SuperPixelElectronics/STM32_Navigation_Mapping_Car/外壳/电机固定.STEP

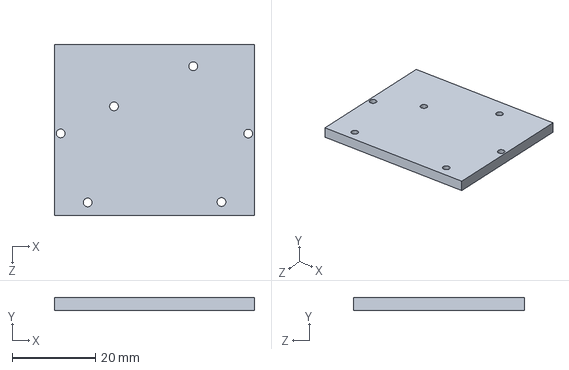
[picture p7: CAD file, 2026-03-30]
外壳/电机固定.STEP
48.0 x 3.00 x 41.0 mm
