SuperPixelElectronics/STM32_Navigation_Mapping_Car/(list of files, cad)

Other CAD files:
外壳/电机固定.SLDPRT
