SuperPixelElectronics/STM32_Navigation_Mapping_Car/其他文档/小车调试笔记.pdf

选型

## 遥控器测试

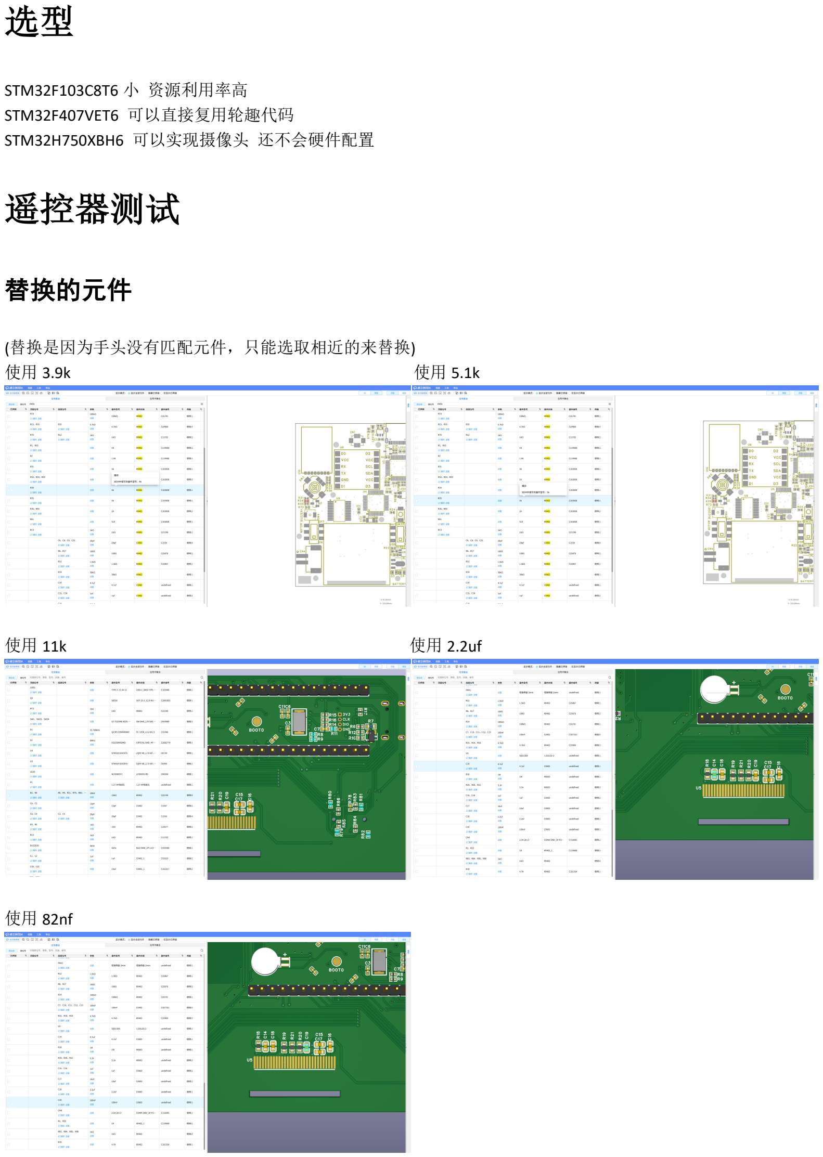
[picture p8: page 1]

STM32F103C8T6 小 资源利用率高
STM32F407VET6 可以直接复用轮趣代码
STM32H750XBH6 可以实现摄像头 还不会硬件配置

替换的元件

(替换是因为手头没有匹配元件，只能选取相近的来替换)
使用 3.9k | 使用 5.1k
使用 11k | 使用 2.2uf

使用 82nf

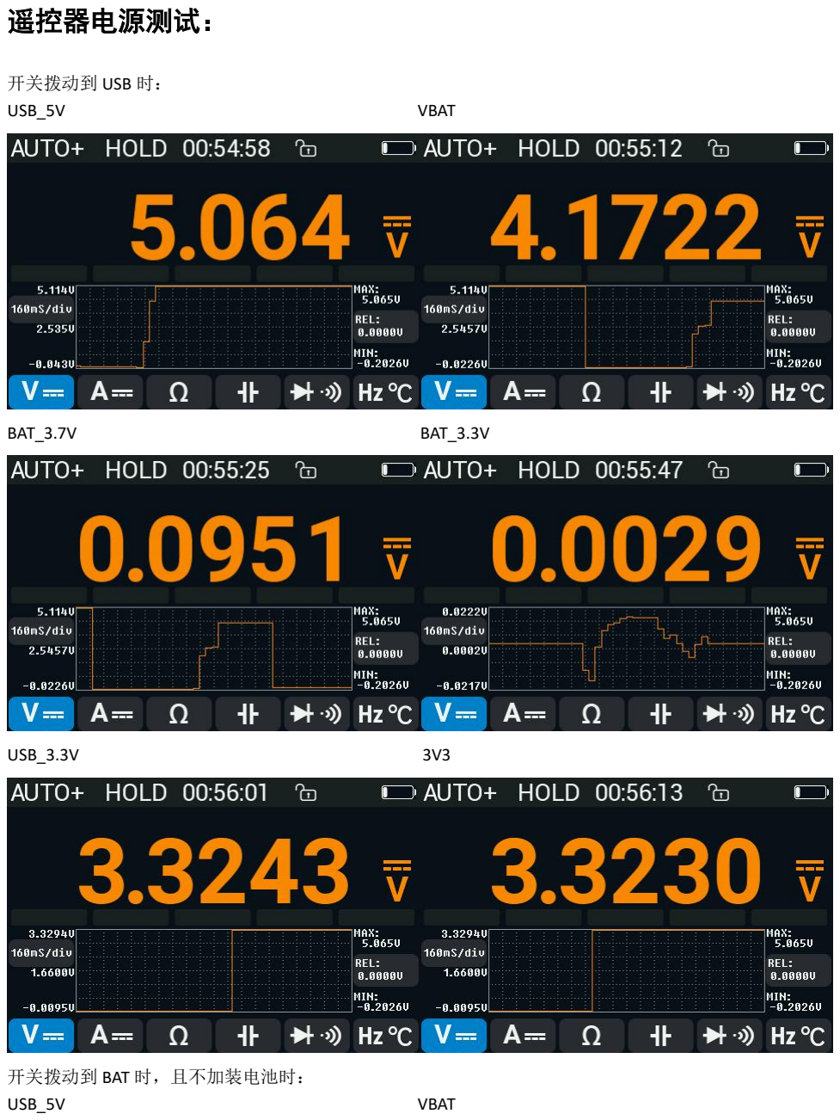
[picture p9: page 2]

遥控器电源测试：

开关拨动到 USB 时：
USB_5V | VBAT
BAT_3.7V | BAT_3.3V
USB_3.3V | 3V3

开关拨动到 BAT 时，且不加装电池时：
USB_5V | VBAT

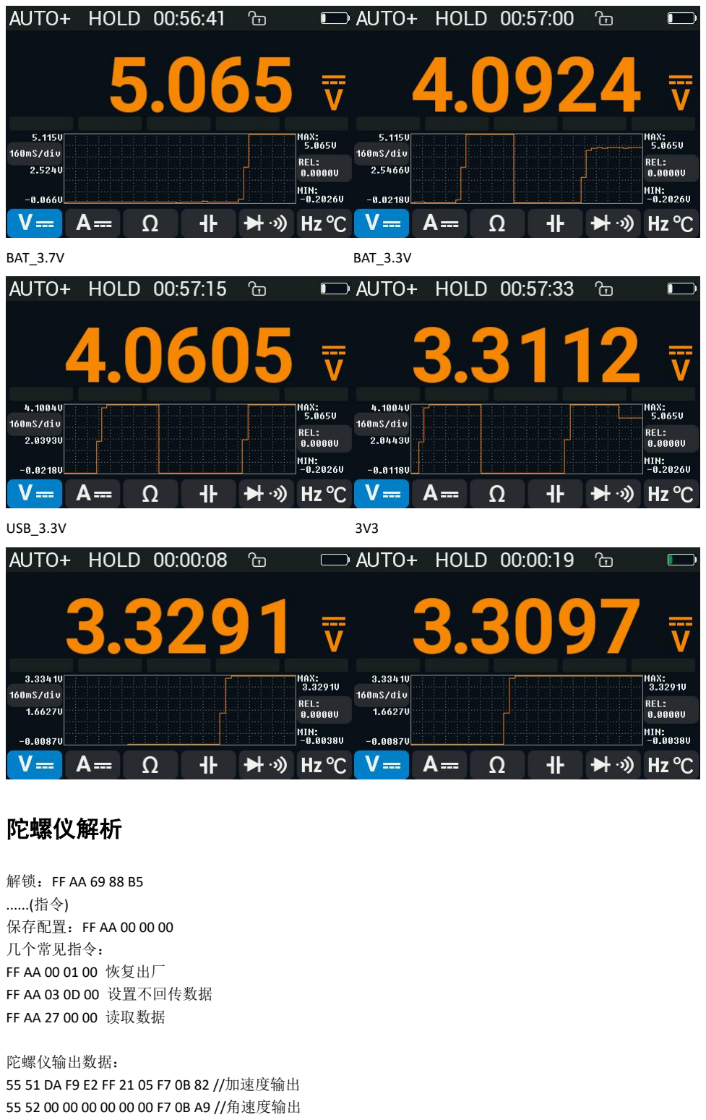
[picture p10: page 3]

BAT_3.7V | BAT_3.3V
USB_3.3V | 3V3

陀螺仪解析

解锁：FF AA 69 88 B5
......(指令)
保存配置：FF AA 00 00 00
几个常见指令：
FF AA 00 01 00 恢复出厂
FF AA 03 0D 00 设置不回传数据
FF AA 27 00 00 读取数据

陀螺仪输出数据：
55 51 DA F9 E2 FF 21 05 F7 0B 82 //加速度输出 55 52 00 00 00 00 00 00 F7 0B A9 //角速度输出

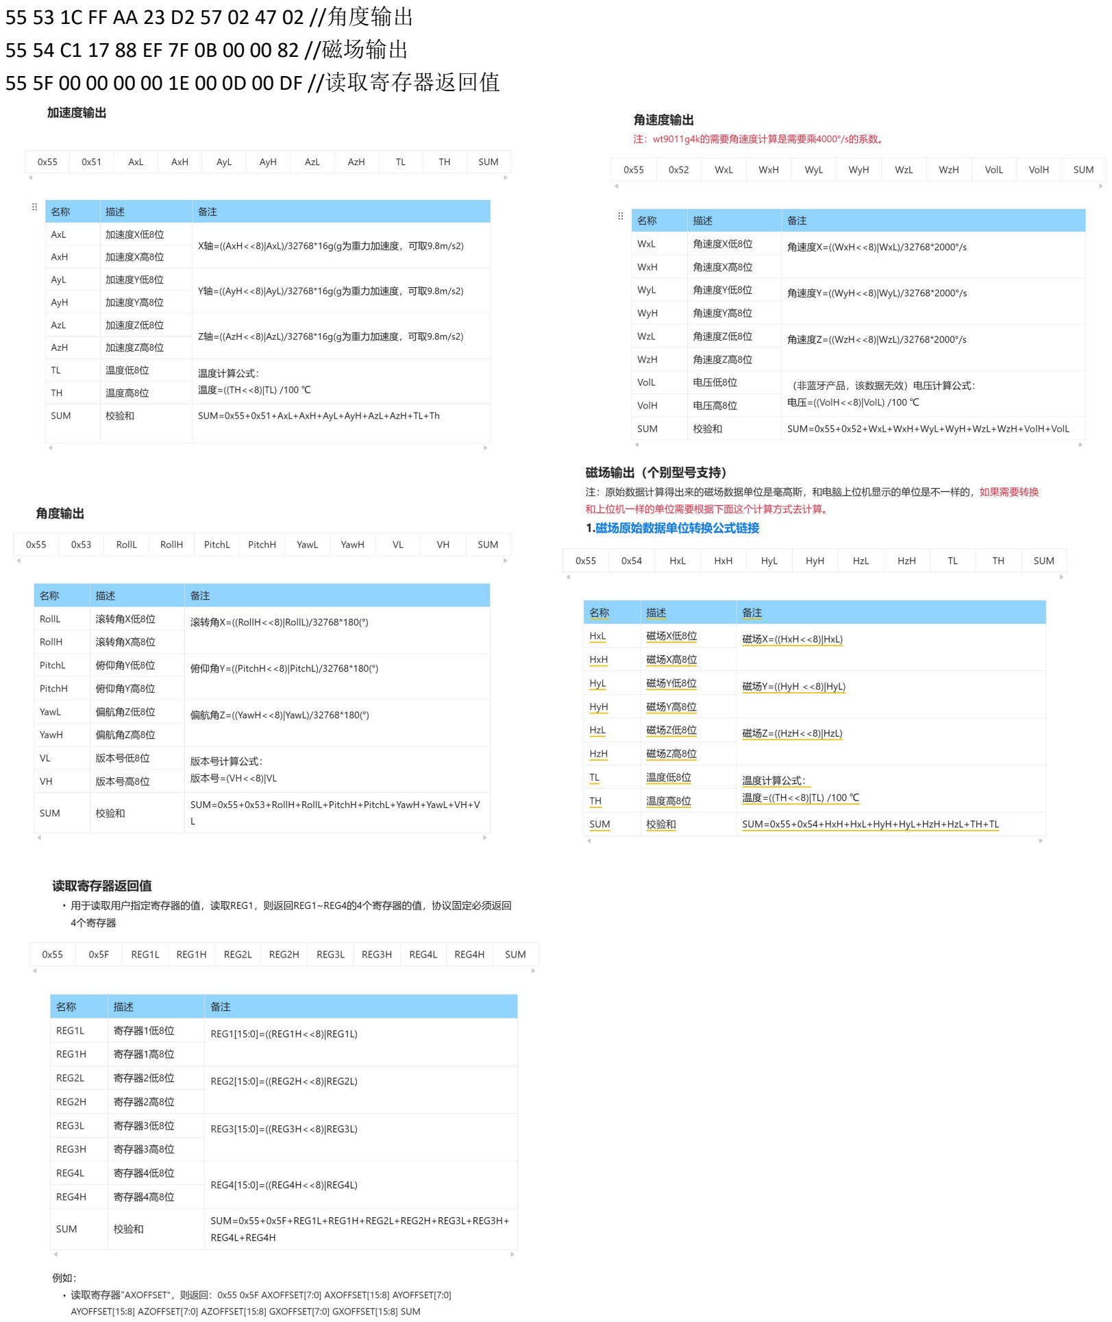
[picture p11: page 4]

55 53 1C FF AA 23 D2 57 02 47 02 //角度输出
55 54 C1 17 88 EF 7F 0B 00 00 82 //磁场输出
55 5F 00 00 00 00 1E 00 0D 00 DF //读取寄存器返回值

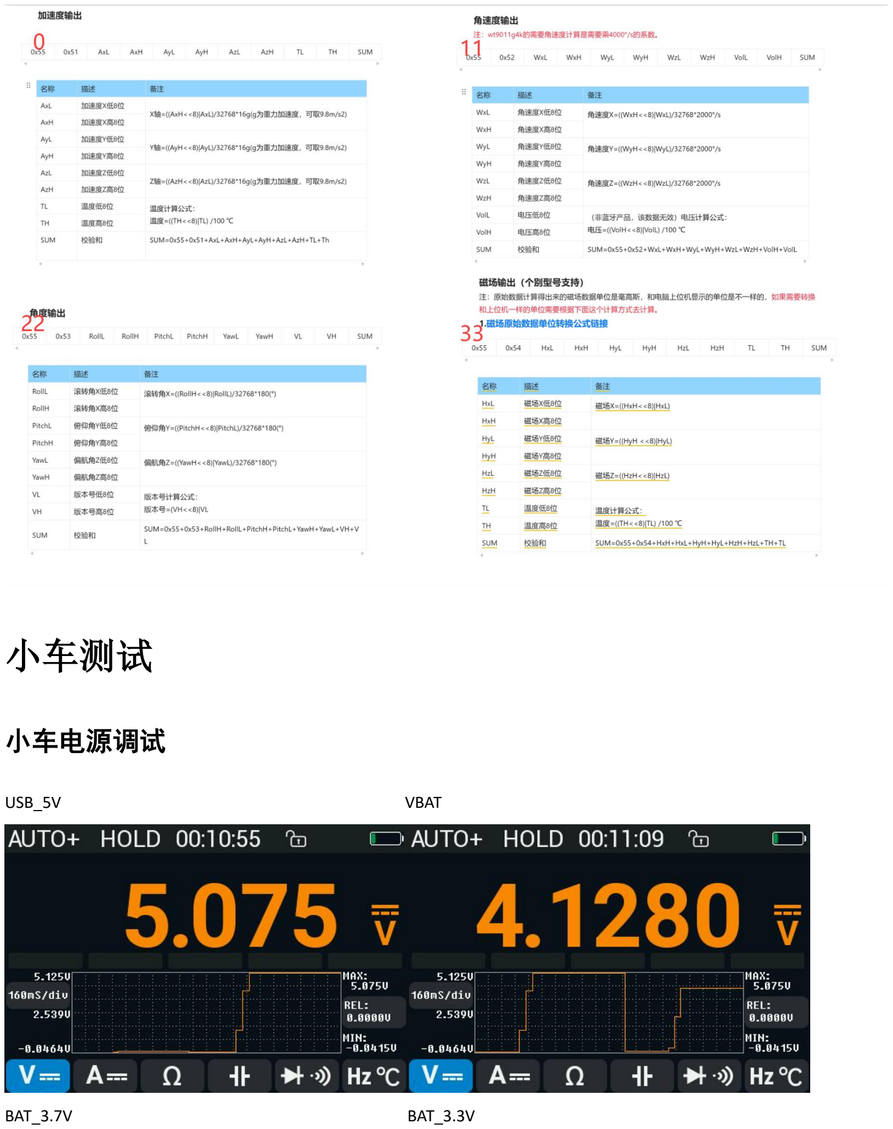
[picture p12: page 5]

## 小车测试

小车电源调试

USB_5V | VBAT
BAT_3.7V | BAT_3.3V

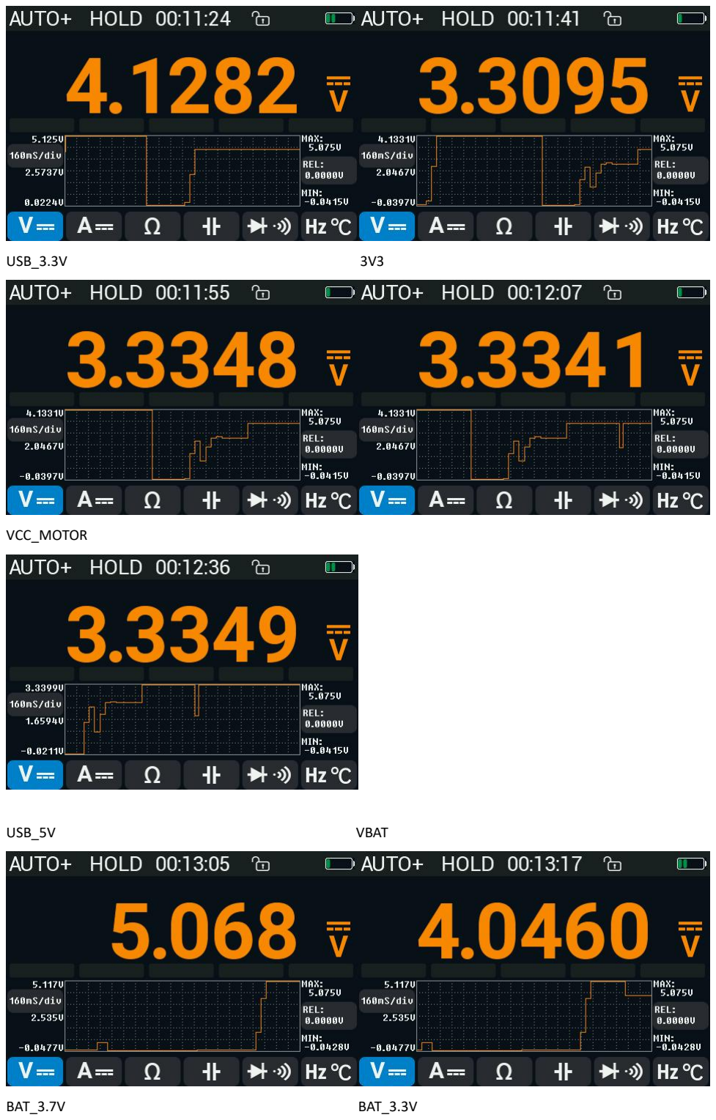
[picture p13: page 6]

USB_3.3V | 3V3

VCC_MOTOR

USB_5V | VBAT
BAT_3.7V | BAT_3.3V

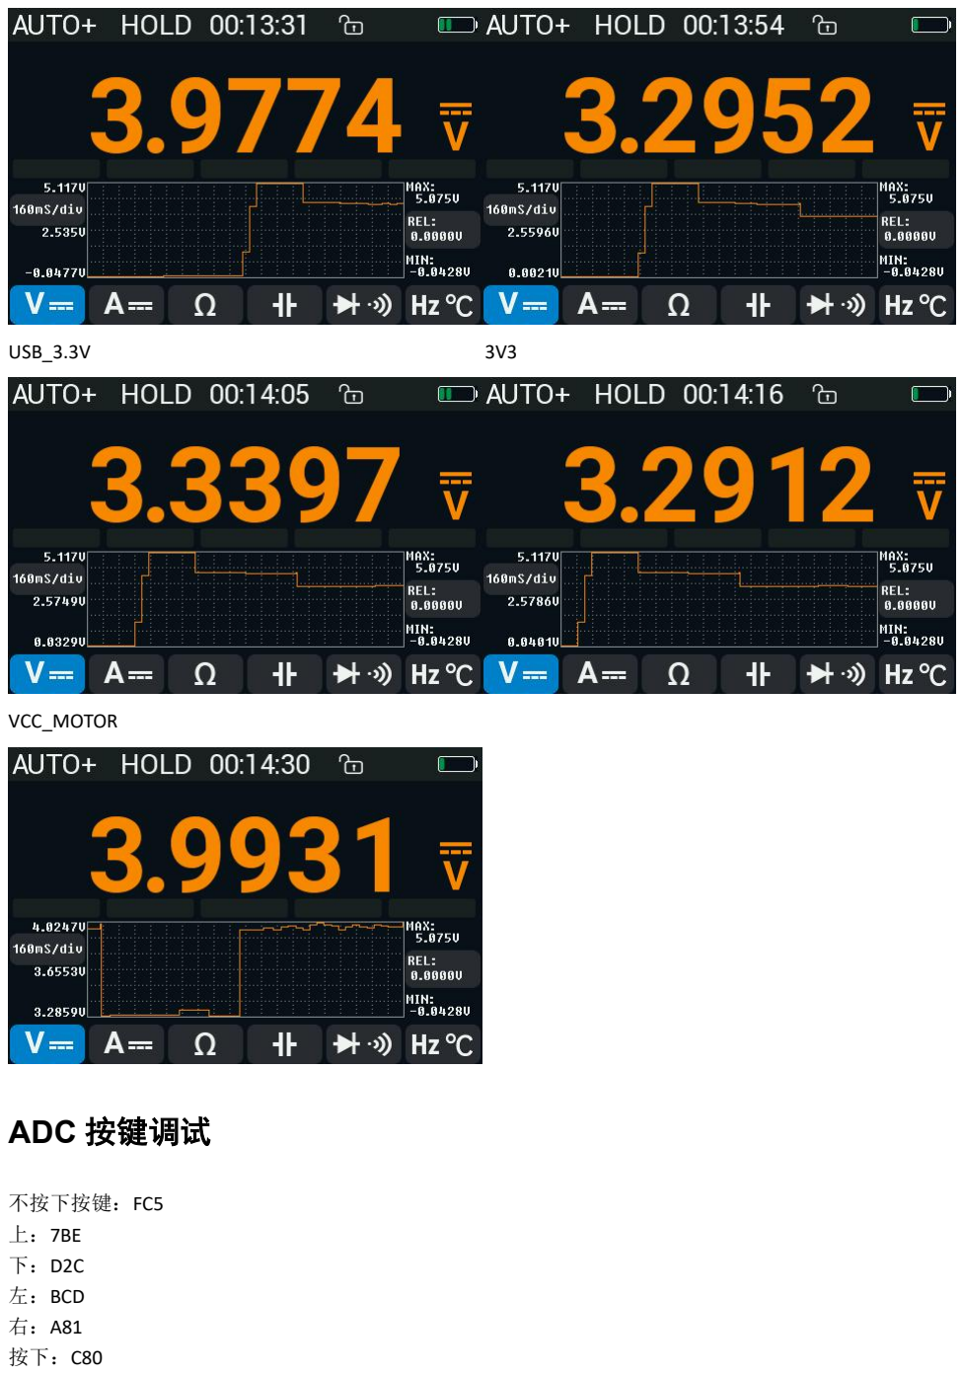
[picture p14: page 7]

USB_3.3V | 3V3

VCC_MOTOR

ADC 按键调试

不按下按键：FC5
上：7BE
下：D2C
左：BCD
右：A81
按下：C80

主要问题

1.stm32 的复位引脚无法上拉

复位引脚一直都无法被那个 10k 电阻或 1k 电阻上拉
在断电的情况下发现他对 vcc 的电阻为 1k，而对 gnd 的电阻为 10k，可是上电之后我发现这个引脚电压只有 0.3 伏，按 下按钮后电压变成零伏
如果拆下这枚芯片的话，复位引脚现象马上就变成正常了，不按下按钮是 3.3 伏按下电流是零伏 后面发现原来是因为芯片换了，更换芯片即可解决

## 2.板载 stlink 忽然无法连接 USB

后面发现是因为 stlink 的 8M 晶振坏了

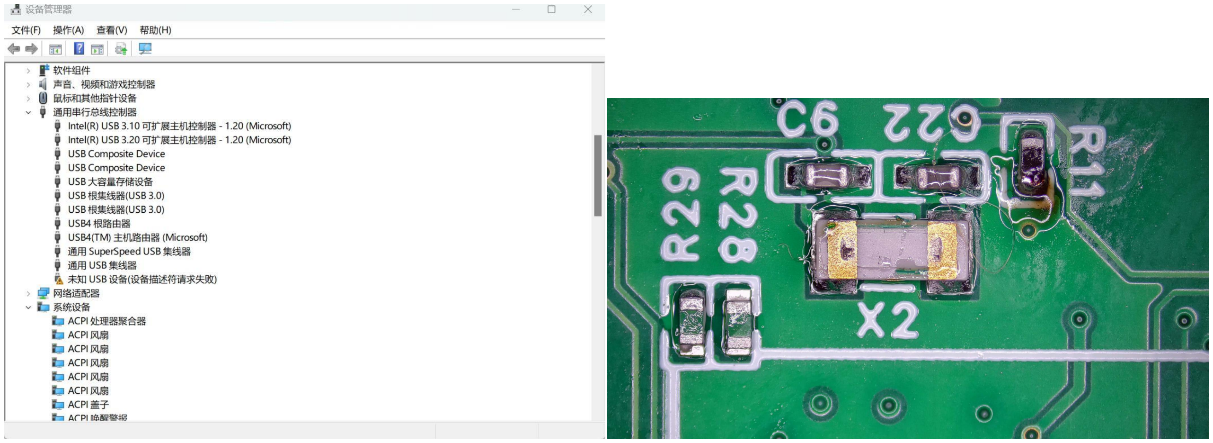
[picture p15: figure]

# Vl53l3 测试

电源测试

使用 82nf

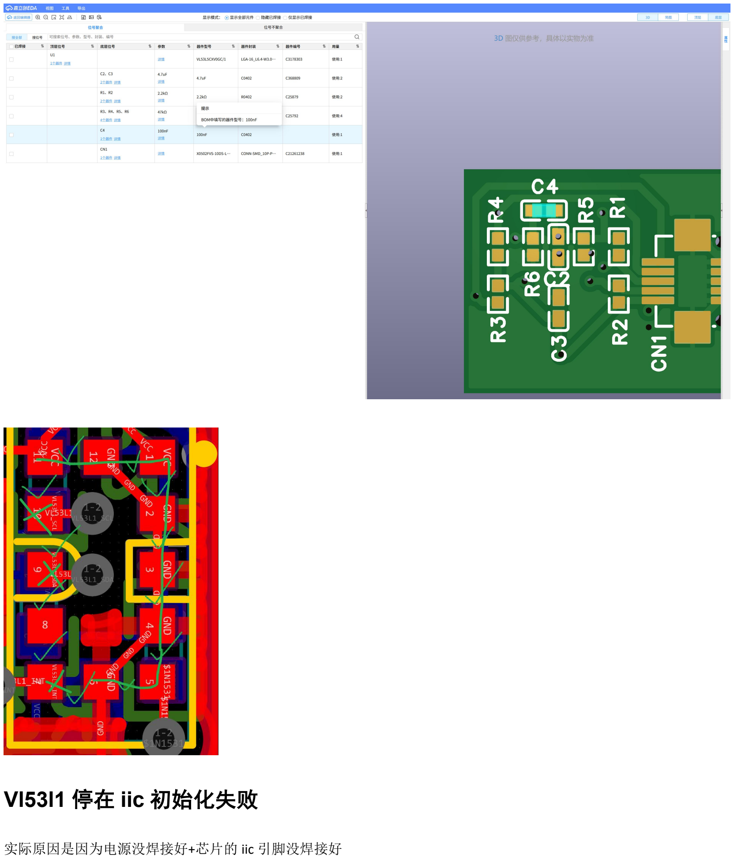
[picture p16: page 9]

## Vl53l1 停在 iic 初始化失败

实际原因是因为电源没焊接好+芯片的 iic 引脚没焊接好
