SuperPixelElectronics/STM32_Navigation_Mapping_Car/hardware/car.pdf

# 电池接入

# 降压模块

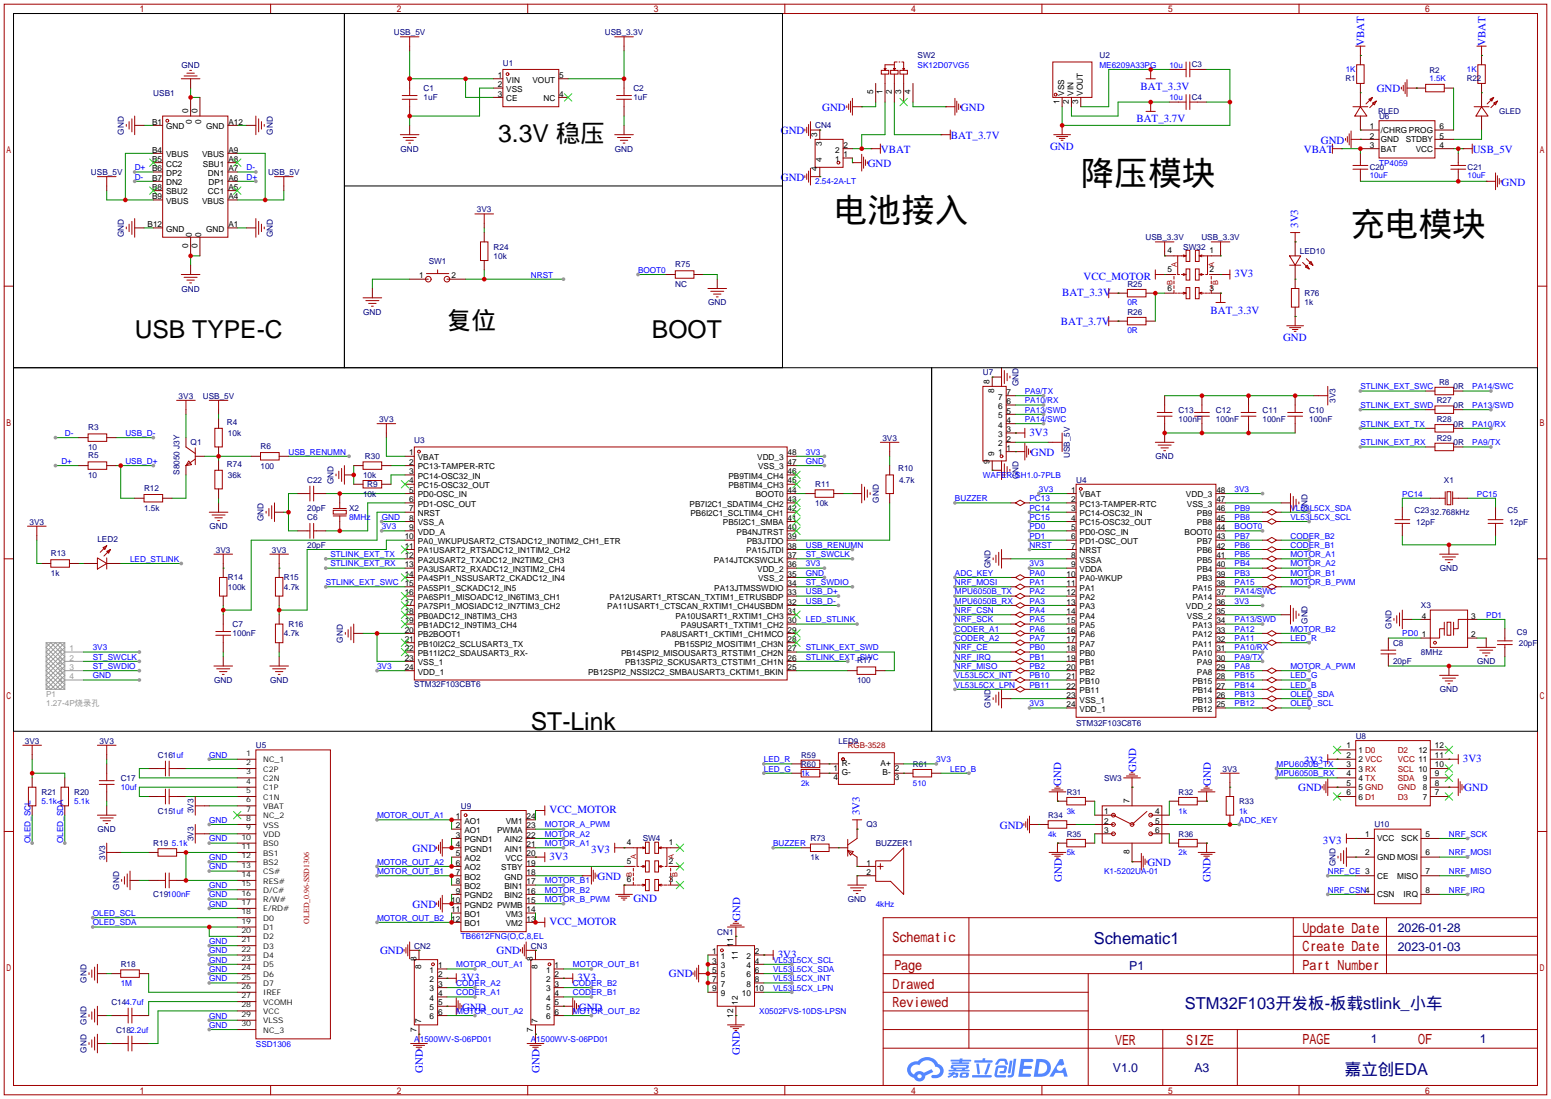
[picture p17: page 1]
