SuperPixelElectronics/STM32_Navigation_Mapping_Car/hardware/controler.pdf

# 降压模块

# 充电模块

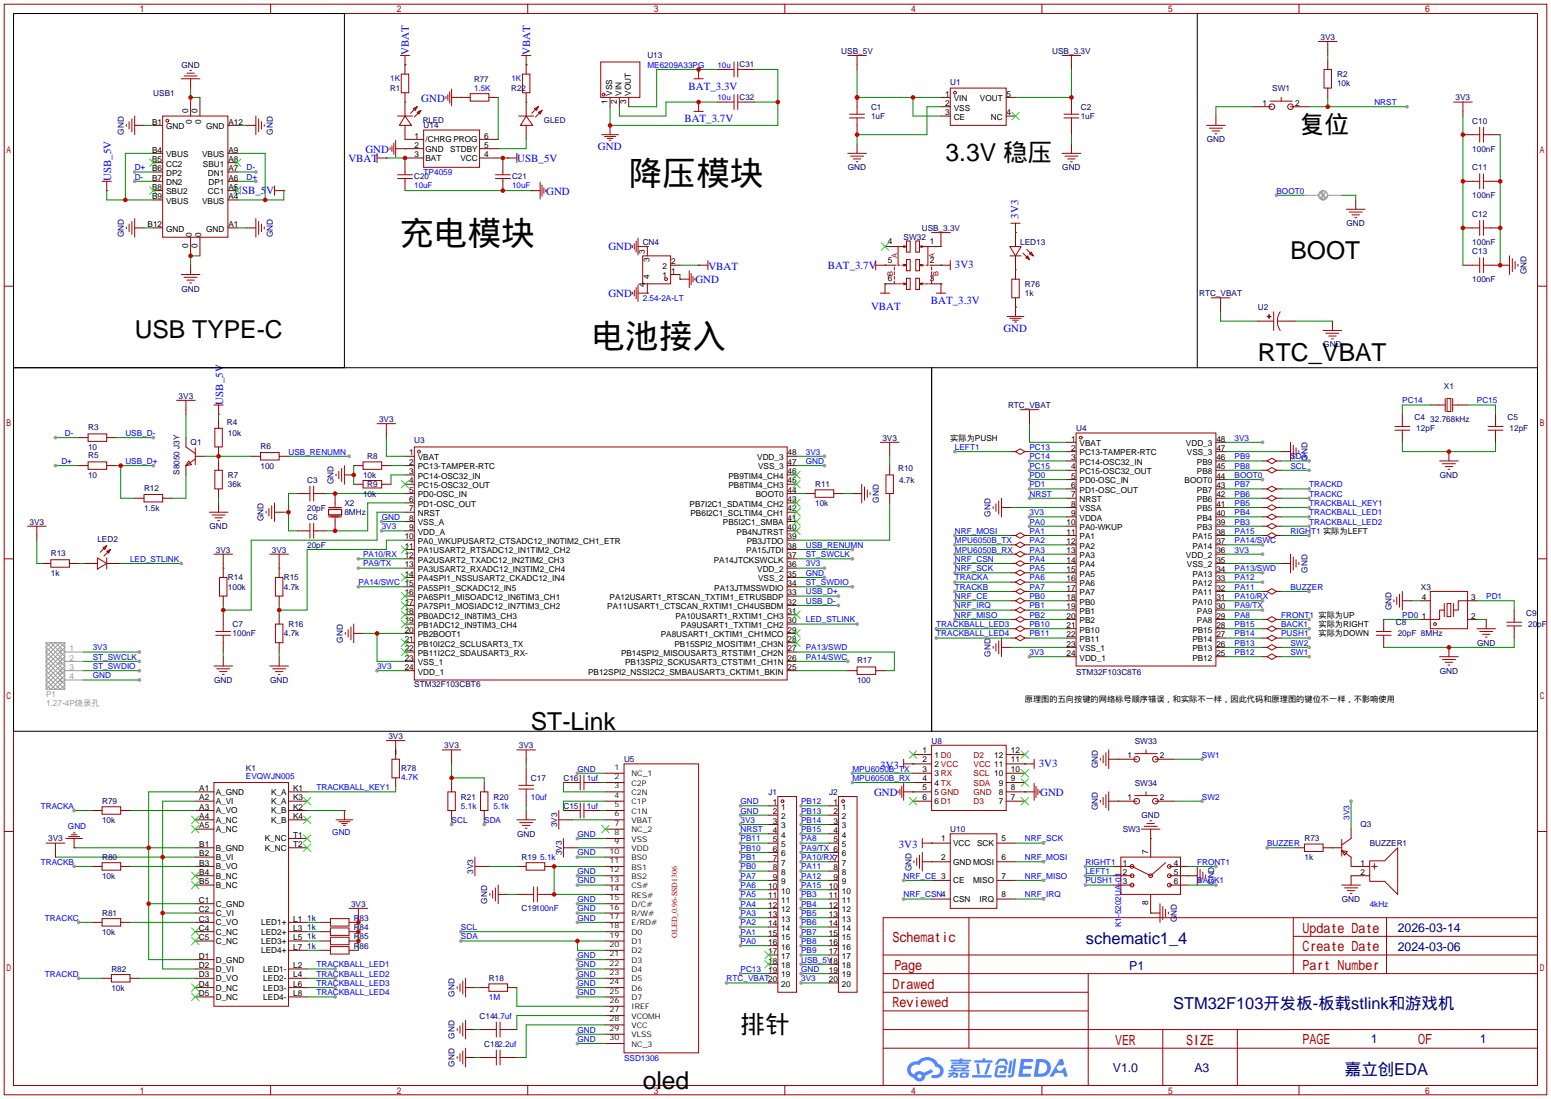
[picture p18: page 1]

原理图的五向按键的网络标号顺序错误，和实际不一样，因此代码和原理图的键位不一样，不影响使用
