SuperPixelElectronics/STM32_Navigation_Mapping_Car/hardware/VL53L1.pdf

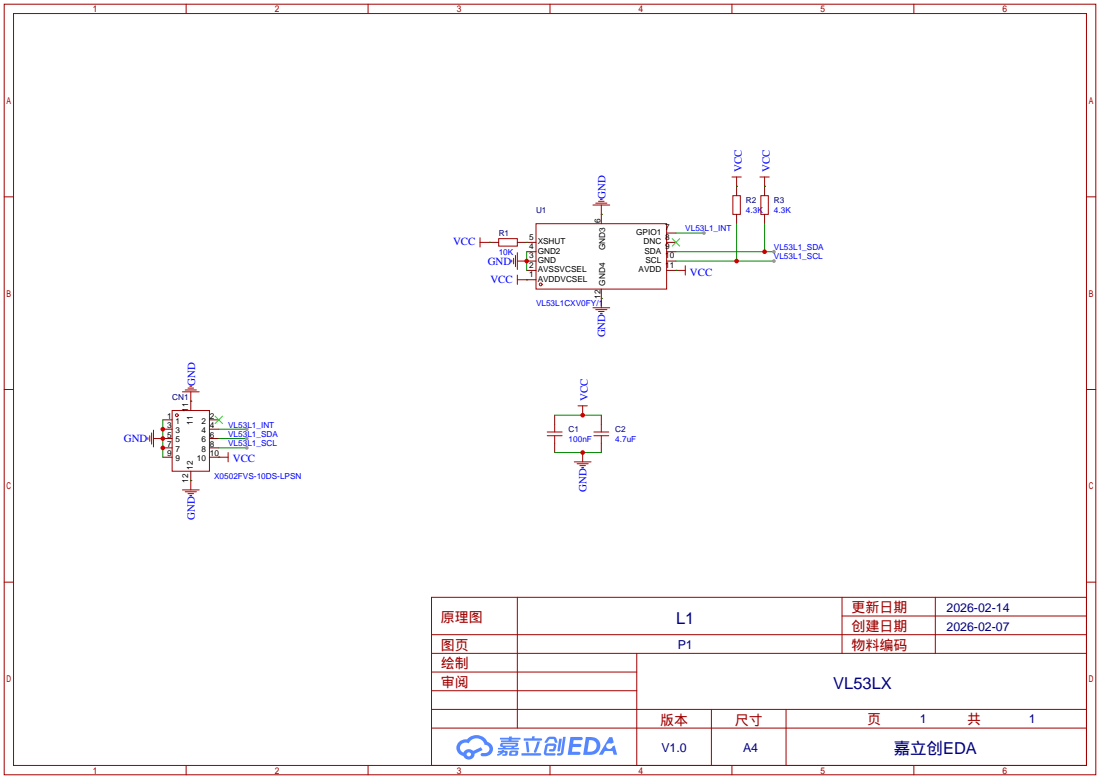
[picture p19: page 1]
