SuperPixelElectronics/STM32_Navigation_Mapping_Car/(list of files, drawings)

Other design files:
hardware/car.epro
hardware/controler.epro
hardware/VL53L1.epro
