SuperPixelElectronics/STM32_Navigation_Mapping_Car/code/car/Core/Src/main.c

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
/* Includes ------------------------------------------------------------------*/
#include "main.h"
#include "adc.h"
#include "tim.h"
#include "usart.h"
#include "gpio.h"

/* USER CODE BEGIN Includes */
#include "system.h"
/* USER CODE END Includes */


void SystemClock_Config(void);
/* USER CODE BEGIN 0 */

uint32_t ms_cnt = 0;

/**
 * @brief 各个时间点的定时执行函数
 */
void time_1ms_function()
{
  buzzer_process();
}
void time_10ms_function()
{
  position_10ms_process();
}
void time_100ms_function()
{
}
void time_1s_function()
{
}
void HAL_TIM_PeriodElapsedCallback(TIM_HandleTypeDef *htim)
{
  if (htim->Instance == TIM1)
  {
    ms_cnt++;
    time_1ms_function();
    if (ms_cnt % 10 == 0)
    {
      time_10ms_function();
    }
    if (ms_cnt % 100 == 0)
    {
      time_100ms_function();
    }
    if (ms_cnt == 1000) // 最开始写成了“ ms_cnt = 1000 ”导致if一直被执行，ms_cnt一直被自动赋值为0
    {
      time_1s_function();
      ms_cnt = 0;
    }
  }
}

/**
 * @brief 串口中断函数
 */
void HAL_UART_RxCpltCallback(UART_HandleTypeDef *huart)
{
  if (huart == &huart2)
  {
    MPU_UART_Receive();
  }
  else if (huart == &huart1)
  {
    uart1_receivce();
  }
}

/**
 * @brief 各个时间点的定时执行函数
 * @param num 需要记录第几个函数的执行时间
 */
void caculate_tick(int num)
{
  static uint32_t last_time = 0;
  uint32_t current_time = HAL_GetTick();

  if (num == 0)
  {
    // 第一个任务：从循环开始到第一个任务结束的时间
    main_during_tick[0] = (int)(current_time - main_start_tick);
    if (main_during_tick[0] > main_during_tick_max[0])
    {
      main_during_tick_max[0] = main_during_tick[0];
    }
  }
  else
  {
    // 其他任务：从上个任务结束到当前任务结束的时间
    main_during_tick[num] = (int)(current_time - last_time);
    if (main_during_tick[num] > main_during_tick_max[num])
    {
      main_during_tick_max[num] = main_during_tick[num];
    }
  }

  // 保存当前时间，供下一个任务使用
  last_time = current_time;
}

/**
 * @brief nrf外部中断执行函数
 */
void HAL_GPIO_EXTI_Callback(uint16_t GPIO_Pin)
{
  nrf_receive_process_irq();
}

/* USER CODE END 0 */

/**
  * @brief  The application entry point.
  * @retval int
  */
int main(void)
{

  /* MCU Configuration--------------------------------------------------------*/

  /* Reset of all peripherals, Initializes the Flash interface and the Systick. */
  HAL_Init();

  /* Configure the system clock */
  SystemClock_Config();

  /* Initialize all configured peripherals */
  MX_GPIO_Init();
  MX_TIM1_Init();
  MX_TIM2_Init();
  MX_TIM3_Init();
  MX_TIM4_Init();
  MX_USART2_UART_Init();
  MX_ADC1_Init();
  MX_USART1_UART_Init();
  /* USER CODE BEGIN 2 */
  show_init();
  key_init();
  position_init();
  motor_init();
  NRF24L01_Init();
  buzzer_init();
  uart1_init();
  led_init();
  VL53L1_init_all();
  Tracker_Init(&tracker, car_track, current_track_length, 0.1f, 0.8f);

  control_mode = NRF_CTRL;

  /* USER CODE END 2 */

  /* Infinite loop */
  /* USER CODE BEGIN WHILE */
  while (1)
  {
    main_start_tick = HAL_GetTick();

    key_read(), caculate_tick(0);
    key_process(), caculate_tick(1);
    oled_process(), caculate_tick(2);
    oled_display(), caculate_tick(3);
    nrf_receive_process_main(), caculate_tick(4);
    led_process(), caculate_tick(5);
    uart1_process(), caculate_tick(6);
    position_main_process(), caculate_tick(7);
    drive(), caculate_tick(8);
    Update_Map(), caculate_tick(9);

    main_all_tick = HAL_GetTick() - main_start_tick;
    if (main_all_tick > main_all_tick_max)
    {
      main_all_tick_max = main_all_tick;
    }

    /* USER CODE END WHILE */

    /* USER CODE BEGIN 3 */
  }
  /* USER CODE END 3 */
}

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
