SuperPixelElectronics/STM32_Navigation_Mapping_Car/code/car/Core/Inc/main.h

#define BUZZER_Pin GPIO_PIN_13
#define BUZZER_GPIO_Port GPIOC
#define NRF_MOSI_Pin GPIO_PIN_1
#define NRF_MOSI_GPIO_Port GPIOA
#define NRF_CSN_Pin GPIO_PIN_4
#define NRF_CSN_GPIO_Port GPIOA
#define NRF_SCK_Pin GPIO_PIN_5
#define NRF_SCK_GPIO_Port GPIOA
#define NRF_CE_Pin GPIO_PIN_0
#define NRF_CE_GPIO_Port GPIOB
#define NRF_IRQ_Pin GPIO_PIN_1
#define NRF_IRQ_GPIO_Port GPIOB
#define NRF_IRQ_EXTI_IRQn EXTI1_IRQn
#define NRF_MISO_Pin GPIO_PIN_2
#define NRF_MISO_GPIO_Port GPIOB
#define OLED_SCL_Pin GPIO_PIN_12
#define OLED_SCL_GPIO_Port GPIOB
#define OLED_SDA_Pin GPIO_PIN_13
#define OLED_SDA_GPIO_Port GPIOB
#define LED_B_Pin GPIO_PIN_14
#define LED_B_GPIO_Port GPIOB
#define LED_G_Pin GPIO_PIN_15
#define LED_G_GPIO_Port GPIOB
#define LED_R_Pin GPIO_PIN_11
#define LED_R_GPIO_Port GPIOA
#define MOTOR_B2_Pin GPIO_PIN_12
#define MOTOR_B2_GPIO_Port GPIOA
#define MOTOR_B1_Pin GPIO_PIN_3
#define MOTOR_B1_GPIO_Port GPIOB
#define MOTOR_A2_Pin GPIO_PIN_4
#define MOTOR_A2_GPIO_Port GPIOB
#define MOTOR_A1_Pin GPIO_PIN_5
#define MOTOR_A1_GPIO_Port GPIOB
#define VL53_SCL_Pin GPIO_PIN_8
#define VL53_SCL_GPIO_Port GPIOB
#define VL53_SDA_Pin GPIO_PIN_9
#define VL53_SDA_GPIO_Port GPIOB
